vasimv/ard-smoke/schematics/ardsmoke.png

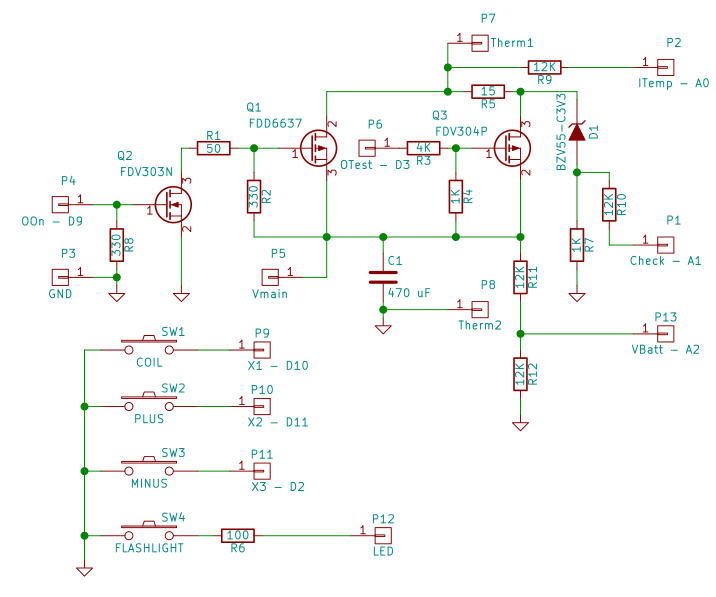
schematics/ardsmoke.png
