vasimv/ard-smoke/(commit log)

2016-01-15 averaging reads for better stability
    [ard-smoke.ino]
2016-01-19 Exit sleep mode fix
    [ard-smoke.ino]
2016-02-16 New schematics with P-FETs (improved stability)
    [ard-smoke.ino]
